johnmgreenwell/rtc-relay/cad/rtc_lamp.sch

## KiCad design cad/rtc_lamp.sch (2021-10-08)

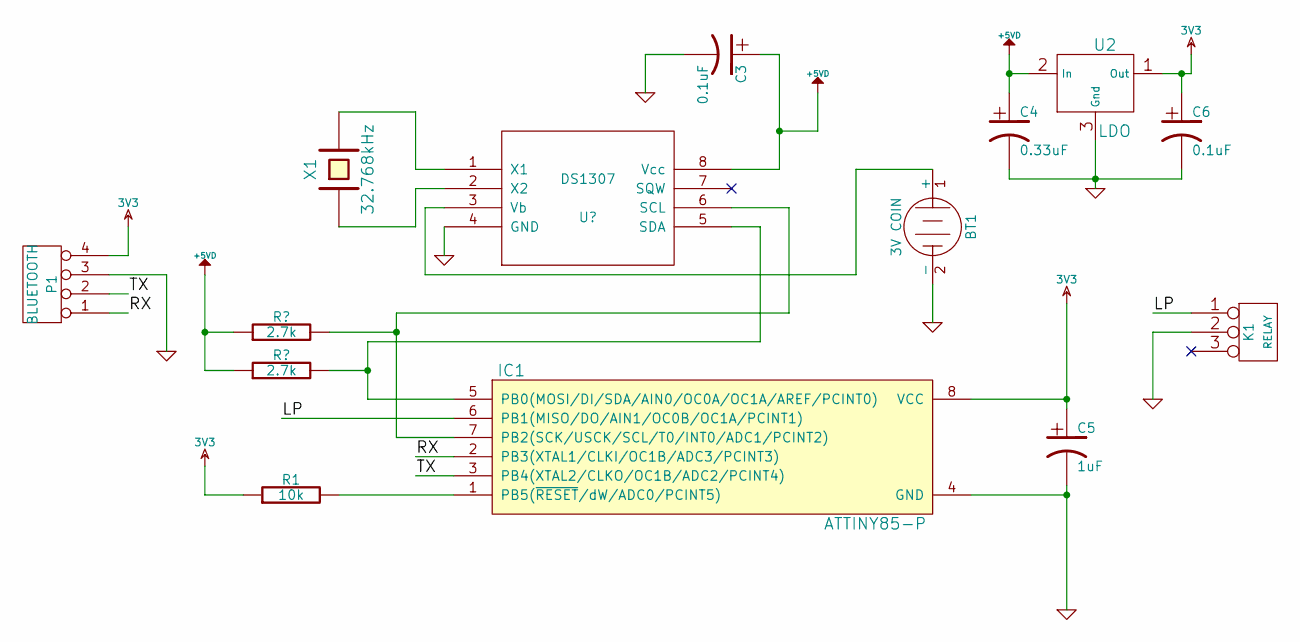
[picture p5: schematic rtc_lamp.sch]

Parts:
BT1: 3V COIN
C3, C6: 0.1uF
C4: 0.33uF
C5: 1uF
IC1: ATTINY85-P; DIP8
K1: RELAY
P1: BLUETOOTH
R1: 10k
U2: LDO
X1: 32.768kHz

Connections:
3V3: C5.1, C6.1, IC1.8 (VCC), P1.4, R1.1, U2.1 (Out)
+5VD: C3.1, C4.1, U2.2 (In)
GND: BT1.2 (-), C3.2, C4.2, C5.2, C6.2, IC1.4 (GND), K1.2 (PM), P1.3, U2.3 (Gnd)
LP: IC1.6 (PB1(MISO/DO/AIN1/OC0B/OC1A/PCINT1)), K1.1
unnamed: IC1.1 (PB5(~RESET~/dW/ADC0/PCINT5)), R1.2
RX: IC1.2 (PB3(XTAL1/CLKI/OC1B/ADC3/PCINT3)), P1.1
TX: IC1.3 (PB4(XTAL2/CLKO/OC1B/ADC2/PCINT4)), P1.2
